matheussmachado/stm32-and-simulink-based-hil-simulation-of-a-2nd-order-model/controller/Core/Src/main.c

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
/* Includes ------------------------------------------------------------------*/
#include "main.h"

/* USER CODE BEGIN Includes */
#include "ControllerModel.h"
#include "ReferenceInputModel.h"
/* USER CODE END Includes */

/* USER CODE BEGIN PD */
#define VOLT_REF 3.33f
#define DATA12_TO_VOLT (VOLT_REF/0xfff)
#define VOLT_TO_PWM_DUTY ((PWM_COUNTER_PERIOD)/VOLT_REF)
/* USER CODE END PD */

ADC_HandleTypeDef hadc1;
DMA_HandleTypeDef hdma_adc1;

TIM_HandleTypeDef htim1;
TIM_HandleTypeDef htim2;
DMA_HandleTypeDef hdma_tim1_ch1;

/* USER CODE BEGIN PV */
uint16_t dma_adc_sensor_input = 0;
uint16_t dma_pwm_duty_out = 0;
uint16_t pwm_out_duty = 0;

float y = 0.f, r = 1.f, e = 0.f, u = 0.f;
/* USER CODE END PV */

void SystemClock_Config(void);
static void MX_GPIO_Init(void);
static void MX_DMA_Init(void);
static void MX_ADC1_Init(void);
static void MX_TIM1_Init(void);
static void MX_TIM2_Init(void);
/**
  * @brief  The application entry point.
  * @retval int
  */
int main(void)
{

  /* MCU Configuration--------------------------------------------------------*/

  /* Reset of all peripherals, Initializes the Flash interface and the Systick. */
  HAL_Init();

  /* Configure the system clock */
  SystemClock_Config();

  /* Initialize all configured peripherals */
  MX_GPIO_Init();
  MX_DMA_Init();
  MX_ADC1_Init();
  MX_TIM1_Init();
  MX_TIM2_Init();
  /* USER CODE BEGIN 2 */
  ControllerModel_initialize();
  ReferenceInputModel_initialize();
  HAL_TIM_PWM_Start_DMA(&htim1, TIM_CHANNEL_1, (uint32_t*) &dma_pwm_duty_out, (uint32_t) 1);
  HAL_ADC_Start_DMA(&hadc1, (uint32_t*) &dma_adc_sensor_input, (uint32_t) 1);
  HAL_TIM_Base_Start_IT(&htim2);
  /* USER CODE END 2 */

  /* Infinite loop */
  /* USER CODE BEGIN WHILE */
  while (1)
  {
    /* USER CODE END WHILE */

    /* USER CODE BEGIN 3 */
  }
  /* USER CODE END 3 */
}

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
/* USER CODE BEGIN 4 */
void HAL_TIM_PeriodElapsedCallback(TIM_HandleTypeDef *htim) {
	if (htim->Instance == htim2.Instance) {
		y = DATA12_TO_VOLT*dma_adc_sensor_input;

		ReferenceInputModel_step();
		r = ReferenceInputModel_Y.r;
		e = r - y;
		ControllerModel_U.e = e;
		ControllerModel_step();
		u = ControllerModel_Y.u;

		dma_pwm_duty_out = VOLT_TO_PWM_DUTY*u;
	}
}
/* USER CODE END 4 */
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
