matheussmachado/stm32-and-simulink-based-hil-simulation-of-a-2nd-order-model/controller/controller.ioc

Mcu.UserName=STM32F401CDUx
PA1.GPIO_Label=ADC_PLANT_OUTPUT
PA1.Signal=ADCx_IN1
PA13.Signal=SYS_JTMS-SWDIO
PA14.Signal=SYS_JTCK-SWCLK
PA8.GPIO_Label=PWM_CONTROL_INPUT
PA8.Signal=S_TIM1_CH1
