matheussmachado/stm32-and-simulink-based-hil-simulation-of-a-2nd-order-model/controller/Core/Inc/main.h

#define PWM_COUNTER_PERIOD 1000-1
#define ADC_PLANT_OUTPUT_Pin GPIO_PIN_1
#define ADC_PLANT_OUTPUT_GPIO_Port GPIOA
#define PWM_CONTROL_INPUT_Pin GPIO_PIN_8
#define PWM_CONTROL_INPUT_GPIO_Port GPIOA
