matheussmachado/stm32-and-simulink-based-hil-simulation-of-a-2nd-order-model/(commit log)

2025-05-11 Plant Simulation: Fixed UART interruption issue; Programmed HIL interfaces | Controller: Programmed control loop. | Simulink: HIL Simulation model.
    [main.c, plant_simulator.ioc]
2025-05-18 updated circuit.png
2025-05-18 updated 2 circuit.png
2025-05-18 updated 3 circuit.png
2025-05-18 updated 4 circuit.png
