matheussmachado/stm32-and-simulink-based-hil-simulation-of-a-2nd-order-model/(notices)

Notices in the files:
controller/Core/Src/main.c:
Copyright (c) 2025 STMicroelectronics.
All rights reserved.
This software is licensed under terms that can be found in the LICENSE file
